skamensky/phone-kvm/hardware/phone-kvm.kicad_pcb

## KiCad design hardware/phone-kvm.kicad_pcb (2026-11-10)

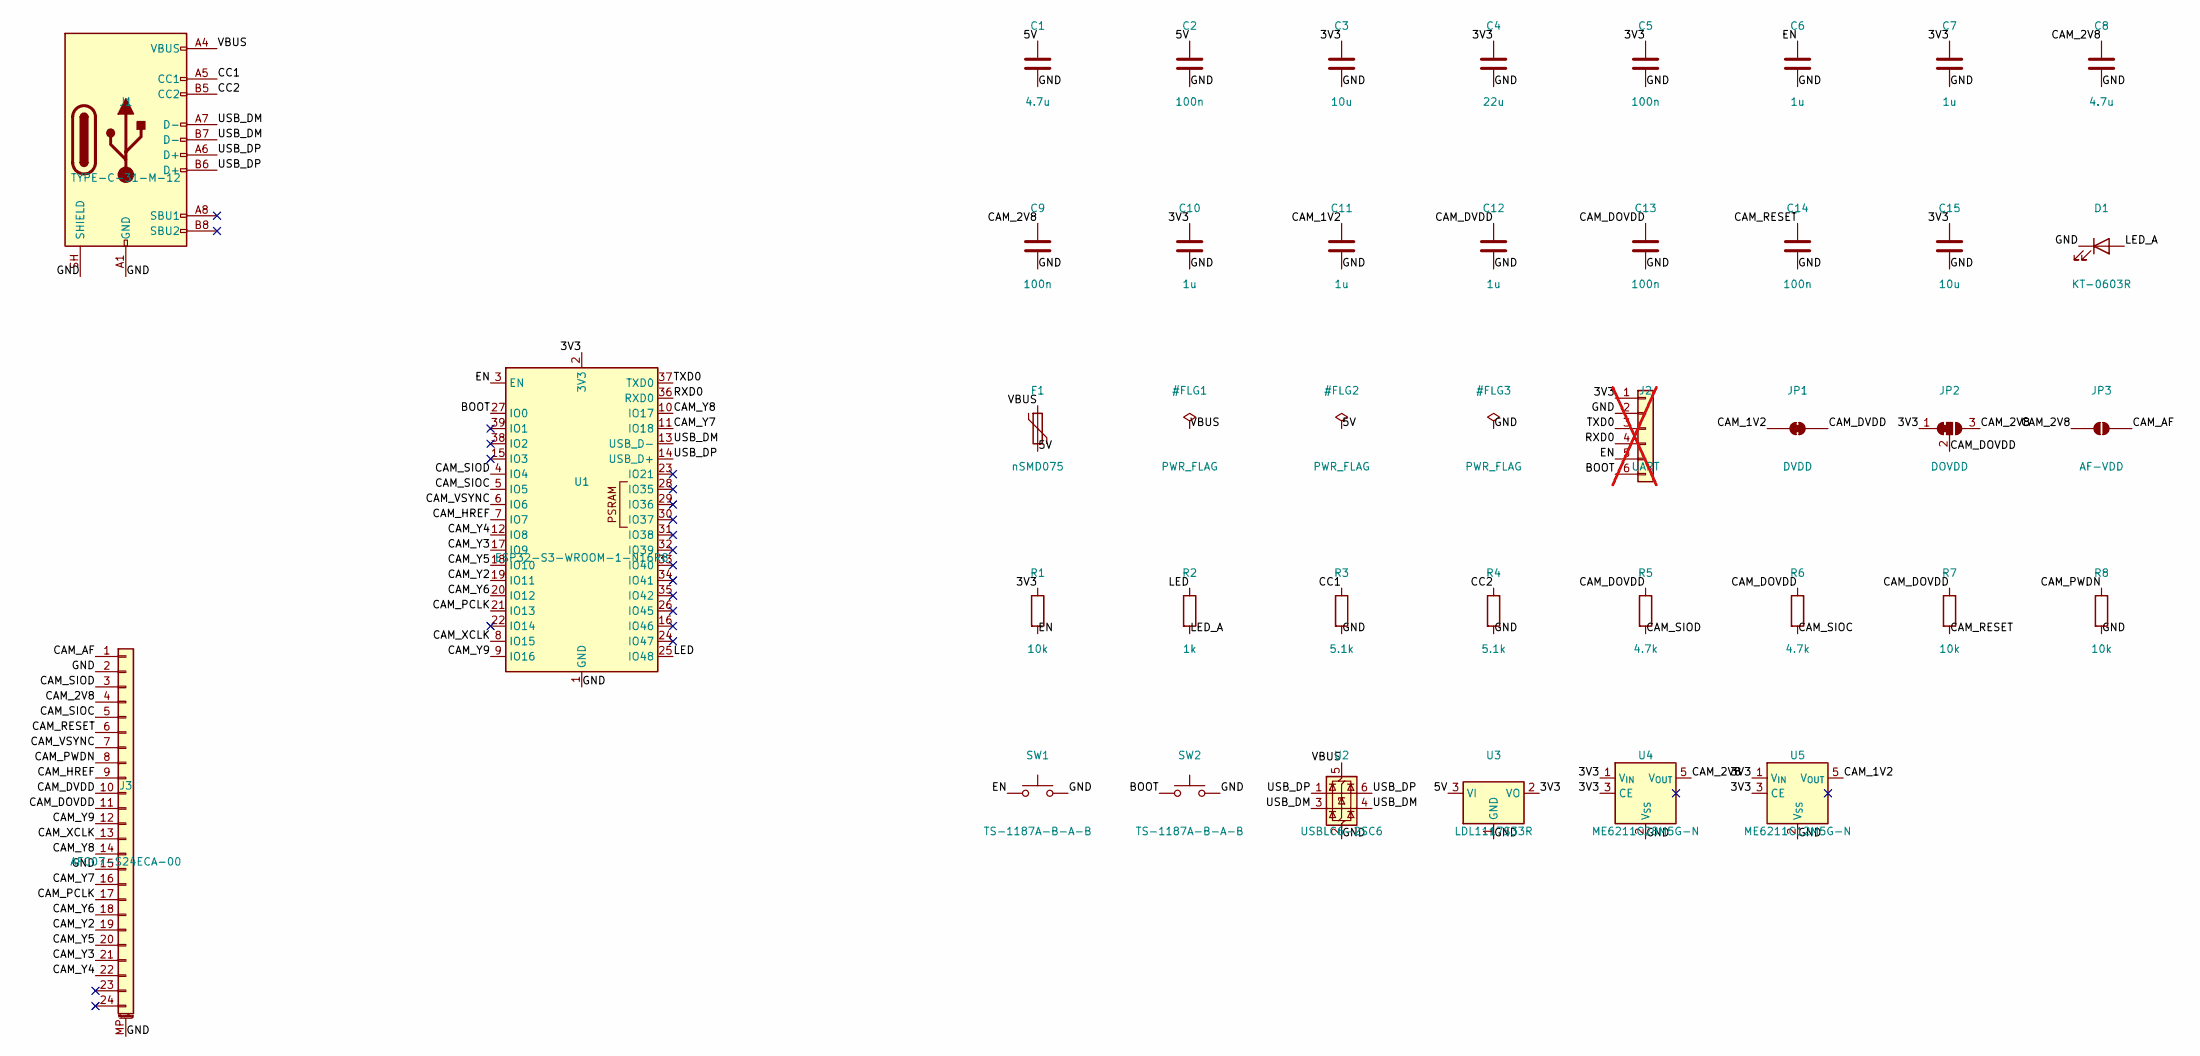
[picture p1: schematic phone-kvm.kicad_sch]

Parts:
C1, C8: 4.7u; C_0603_1608Metric; LCSC C19666
C2, C5, C9, C13, C14: 100n; C_0603_1608Metric; LCSC C14663
C3, C15: 10u; C_0603_1608Metric; LCSC C19702
C4: 22u; C_0805_2012Metric; LCSC C45783
C6, C7, C10, C11, C12: 1u; C_0603_1608Metric; LCSC C15849
D1: KT-0603R; LED_0603_1608Metric; LCSC C2286
F1: nSMD075; Fuse_1206_3216Metric; LCSC C70078
J1: TYPE-C-31-M-12; USB_C_Receptacle_HRO_TYPE-C-31-M-12; LCSC C165948
J2: UART; PinHeader_1x06_P2.54mm_Vertical; not fitted
J3: AFC07-S24ECA-00; Jushuo_AFC07-S24FCA-00_1x24-1MP_P0.50_Horizontal; LCSC C262643
JP1: DVDD; SolderJumper-2_P1.3mm_Bridged_RoundedPad1.0x1.5mm
JP2: DOVDD; SolderJumper-3_P1.3mm_Bridged12_RoundedPad1.0x1.5mm
JP3: AF-VDD; SolderJumper-2_P1.3mm_Open_RoundedPad1.0x1.5mm
R1, R7, R8: 10k; R_0603_1608Metric; LCSC C25804
R2: 1k; R_0603_1608Metric; LCSC C21190
R3, R4: 5.1k; R_0603_1608Metric; LCSC C23186
R5, R6: 4.7k; R_0603_1608Metric; LCSC C23162
SW1, SW2: TS-1187A-B-A-B; SW_Push_1P1T_XKB_TS-1187A; LCSC C318884
U1: ESP32-S3-WROOM-1-N16R8; ESP32-S3-WROOM-1; LCSC C2913202
U2: USBLC6-2SC6; SOT-23-6; LCSC C7519
U3: LDL1117S33R; SOT-223-3_TabPin2; LCSC C435835
U4: ME6211C28M5G-N; SOT-23-5; LCSC C53099
U5: ME6211C12M5G-N; SOT-23-5; LCSC C236672

Connections:
/3V3: C3.1, C4.1, C5.1, C7.1, C10.1, C15.1, J2.1, JP2.1 (A), R1.1, U1.2 (3V3), U3.2 (VO), U4.1 (V_{IN}), U4.3 (CE), U5.1 (V_{IN}), U5.3 (CE)
/5V: C1.1, C2.1, F1.2, U3.3 (VI)
/BOOT: J2.6, SW2.1, U1.27 (IO0)
/CAM_1V2: C11.1, JP1.1 (A), U5.5 (V_{OUT})
/CAM_2V8: C8.1, C9.1, J3.4, JP2.3 (B), JP3.1 (A), U4.5 (V_{OUT})
/CAM_AF: J3.1, JP3.2 (B)
/CAM_DOVDD: C13.1, J3.11, JP2.2 (C), R5.1, R6.1, R7.1
/CAM_DVDD: C12.1, J3.10, JP1.2 (B)
/CAM_HREF: J3.9, U1.7 (IO7)
/CAM_PCLK: J3.17, U1.21 (IO13)
/CAM_PWDN: J3.8, R8.1
/CAM_RESET: C14.1, J3.6, R7.2
/CAM_SIOC: J3.5, R6.2, U1.5 (IO5)
/CAM_SIOD: J3.3, R5.2, U1.4 (IO4)
/CAM_VSYNC: J3.7, U1.6 (IO6)
/CAM_XCLK: J3.13, U1.8 (IO15)
/CAM_Y2: J3.19, U1.19 (IO11)
/CAM_Y3: J3.21, U1.17 (IO9)
/CAM_Y4: J3.22, U1.12 (IO8)
/CAM_Y5: J3.20, U1.18 (IO10)
/CAM_Y6: J3.18, U1.20 (IO12)
/CAM_Y7: J3.16, U1.11 (IO18)
/CAM_Y8: J3.14, U1.10 (IO17)
/CAM_Y9: J3.12, U1.9 (IO16)
/CC1: J1.A5 (CC1), R3.1
/CC2: J1.B5 (CC2), R4.1
/EN: C6.1, J2.5, R1.2, SW1.1, U1.3 (EN)
/GND: C1.2, C2.2, C3.2, C4.2, C5.2, C6.2, C7.2, C8.2, C9.2, C10.2, C11.2, C12.2, C13.2, C14.2, C15.2, D1.1 (K), J1.A1 (GND), J1.A12 (GND), J1.B1 (GND), J1.B12 (GND), J1.SH (SHIELD), J2.2, J3.2, J3.15, J3.MP (MountPin), R3.2, R4.2, R8.2, SW1.2, SW2.2, U1.1 (GND), U1.40 (GND), U1.41 (GND), U2.2 (GND), U3.1 (GND), U4.2 (V_{SS}), U5.2 (V_{SS})
/LED: R2.1, U1.25 (IO48)
/LED_A: D1.2 (A), R2.2
/RXD0: J2.4, U1.36 (RXD0)
/TXD0: J2.3, U1.37 (TXD0)
/USB_DM: J1.A7 (D-), J1.B7 (D-), U1.13 (USB_D-), U2.3 (I/O2), U2.4 (I/O2)
/USB_DP: J1.A6 (D+), J1.B6 (D+), U1.14 (USB_D+), U2.1 (I/O1), U2.6 (I/O1)
/VBUS: F1.1, J1.A4 (VBUS), J1.A9 (VBUS), J1.B4 (VBUS), J1.B9 (VBUS), U2.5 (VBUS)

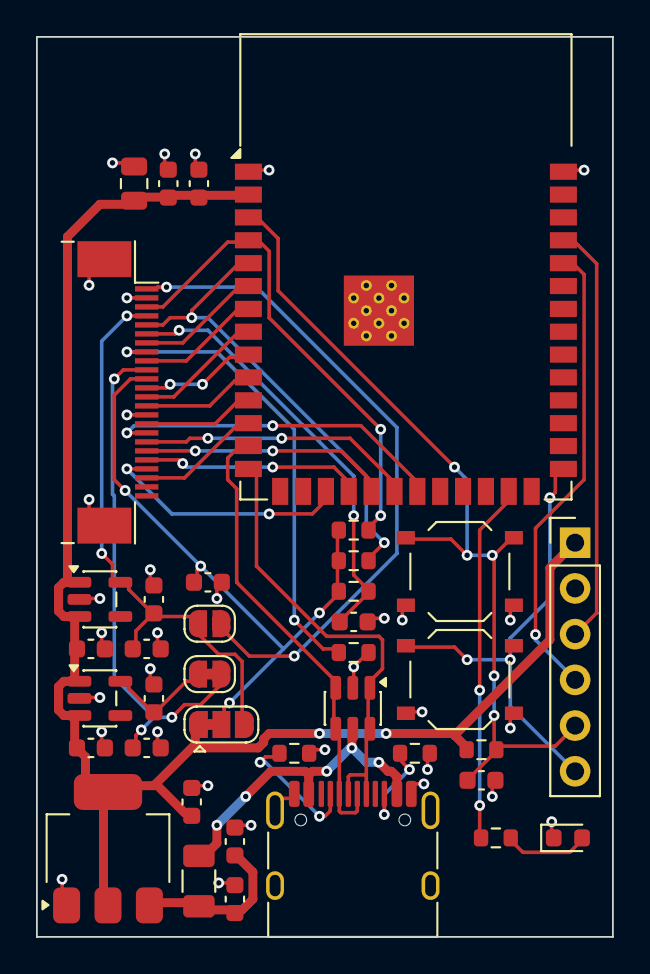
[picture p2: board phone-kvm.kicad_pcb from above]

Board: 2 copper layers, 32.0 x 50.0 mm, 38 parts (0 on the bottom side), 35 nets.
