skamensky/phone-kvm/tests/test_rig.py

"""The device against the virtual phone. Input goes in only through `phonectl` (USB HID) and
the screen comes out only through `phonectl screenshot`; adb is the oracle that says what
Android actually did. The device is the simulated board running the real firmware, and it sees
the phone through its camera. Needs `bin/rig up`; skipped otherwise.
"""
import io
import json
import os
import re
import shlex
import subprocess
import sys
import time
import xml.etree.ElementTree as ET

import pytest
from PIL import Image, ImageChops, ImageStat

from phone_kvm import hid  # noqa: E402

if "ANDROID_HOME" not in os.environ:
    pytest.skip("not in the project's Nix shell", allow_module_level=True)
from rig.__main__ import ADB, BUILD, CONFIG, ENV, PHONE, SERIAL, adb, status  # noqa: E402

if PHONE.exists() and PHONE.read_text() == "real":
    pytest.skip("the rig is up with a real phone; these tests check against the virtual one", allow_module_level=True)

if not status()["ready"]:
    pytest.skip("the rig is not up (bin/rig up)", allow_module_level=True)

DEVICE_ENV = {**os.environ, "PHONE_KVM_STATE": str(BUILD / "state")}


def phonectl(*args):
    done = subprocess.run([sys.executable, "-m", "phone_kvm.cli", *map(str, args)],
                          capture_output=True, text=True, env=DEVICE_ENV)
    result = json.loads(done.stdout)
    assert done.returncode == 0, result
    return result


def until(check, seconds=8):
    """Poll the oracle: the phone takes up to a second to show what it was told."""
    deadline = time.monotonic() + seconds
    while True:
        value = check()
        # An XML element without children is falsy, so compare with None and False explicitly.
        if (value is not None and value is not False) or time.monotonic() > deadline:
            return value if value is not False else None
        time.sleep(0.3)


def nodes():
    xml = adb("exec-out", "uiautomator", "dump", "/dev/tty", check=False).stdout
    xml = xml[:xml.rfind(">") + 1]
    return list(ET.fromstring(xml).iter("node")) if xml.startswith("<?xml") else []


def node(**attributes):
    return next((n for n in nodes() if all(n.get(k.rstrip("_").replace("_", "-")) == v for k, v in attributes.items())), None)


def bounds(n):
    return tuple(map(int, re.findall(r"\d+", n.get("bounds"))))


def centre(n, at=0.5):
    """A point in a node, in screenshot pixels (the unit phonectl takes)."""
    left, top, right, bottom = bounds(n)
    width, height = map(int, re.search(r"(\d+)x(\d+)", adb("shell", "wm", "size").stdout).groups())
    return (round((left + (right - left) * at) * SCREEN[0] / width), round((top + bottom) / 2 * SCREEN[1] / height))


def focus():
    return adb("shell", "dumpsys", "window").stdout.split("mCurrentFocus=")[1].split("\n")[0]


def events(action, seconds=1.5):
    """Raw kernel input events Android received while `action` ran."""
    listener = subprocess.Popen([ADB, "-s", SERIAL, "shell", "getevent", "-l"], stdout=subprocess.PIPE,
                                text=True, env=ENV)
    time.sleep(0.7)
    action()
    time.sleep(seconds)
    listener.terminate()
    return listener.communicate()[0]


@pytest.fixture(scope="module", autouse=True)
def awake():
    for secret in CREDENTIALS:   # a failed earlier run may have left the phone locked
        adb("shell", "locksettings", "clear", "--old", shlex.quote(secret), check=False)
    if "Awake" not in adb("shell", "dumpsys", "power").stdout:
        phonectl("key", "power")
    dismiss()
    phonectl("key", "home")
    # Just after boot the launcher is still starting.
    assert until(lambda: "NexusLauncherActivity" in focus() and node(text="Chrome") is not None, 90)
    global SCREEN
    phonectl("setup", "--device", CONFIG["device"], "--rotate", CONFIG["rotate"])
    # A camera finds the screen by its light: Settings is light to all four edges, the home
    # screen's wallpaper is not. Then the pointer on the home screen, which is still.
    phonectl("key", "meta+i")
    assert until(lambda: "com.android.settings" in focus())   # any of its pages is light
    time.sleep(2)
    phonectl("calibrate", "screen")
    phonectl("key", "home")
    assert until(lambda: "NexusLauncherActivity" in focus())
    time.sleep(1)
    result = phonectl("calibrate", "pointer")
    SCREEN = result["width"], result["height"]


@pytest.fixture(autouse=True)
def home():
    phonectl("key", "home")
    assert until(lambda: "NexusLauncherActivity" in focus() and node(text="Chrome") is not None)


PIN, PASSWORD, PATTERN = "271828", "Tr0ub4dor&3 {x}~", "14789"
CREDENTIALS = [PIN, PASSWORD, PATTERN]


def locked():
    return "isKeyguardShowing=true" in adb("shell", "dumpsys", "window").stdout


def dismiss():
    """Oracle-side cleanup: leave the phone awake and past a lock screen that has no credential."""
    def gone():
        adb("shell", "wm", "dismiss-keyguard")
        time.sleep(1)
        if locked():   # an entry screen left open after a refused credential: sleep and wake
            adb("shell", "input", "keyevent", "26")
            time.sleep(2)
            adb("shell", "input", "keyevent", "26")
            time.sleep(2)
        return not locked()
    assert until(gone, 15)


def wakefulness():
    return re.search(r"mWakefulness=(\w+)", adb("shell", "dumpsys", "power").stdout).group(1)


def lock_with(kind, secret):
    """Give the phone a screen lock (through adb: the oracle's side), then lock it with the
    power key and wake it to the lock screen, as its owner would find it."""
    assert "set to" in adb("shell", "locksettings", f"set-{kind}", shlex.quote(secret)).stdout
    phonectl("key", "power")
    assert until(lambda: wakefulness() != "Awake")
    time.sleep(1)
    phonectl("key", "power")
    assert until(lambda: wakefulness() == "Awake" and locked())
    time.sleep(1)
    x = SCREEN[0] // 2
    # Up to the entry screen, from above where an on-screen keyboard would be.
    phonectl("swipe", x, SCREEN[1] * 3 // 5, x, SCREEN[1] // 8, "--ms", 250)
    phonectl("screenshot", BUILD / "test-entry.png")   # as an agent would: look before typing


def settings():
    adb("shell", "am", "force-stop", "com.google.android.settings.intelligence")   # its search screen
    adb("shell", "am", "start", "-S", "-n", "com.android.settings/.Settings")
    assert until(lambda: node(text="Network & internet")) is not None


def test_android_enumerates_all_four_interfaces():
    dump = adb("shell", "dumpsys", "input").stdout
    devices = [block for block in dump.split("\n    ") if "vendor=0x1209, product=0x0001" in block]
    # Sources are listed in the lines that follow each identifier; search the whole dump section.
    section = dump[dump.index("Input Reader State"):]
    ours = re.findall(r"Device \d+: phone-kvm.*?(?=\n  Device \d+:|\Z)", section, re.S)
    assert len(ours) == 4, devices
    sources = " ".join(re.search(r"Sources: (.*)", block).group(1) for block in ours)
    for source in ("KEYBOARD", "TOUCHSCREEN", "MOUSE"):
        assert source in sources
    assert all("IsExternal: true" in block for block in ours)


def input_bits(descriptor):
    """Parse a HID report descriptor's short items; return the input report's length in bits."""
    bits = size = count = 0
    i = 0
    while i < len(descriptor):
        prefix = descriptor[i]
        length = (0, 1, 2, 4)[prefix & 3]
        value = int.from_bytes(descriptor[i + 1:i + 1 + length], "little")
        tag = prefix & 0xFC
        assert tag != 0x84, "report IDs would change every report's layout"
        if tag == 0x74:
            size = value
        elif tag == 0x94:
            count = value
        elif tag == 0x80:
            bits += size * count
        i += 1 + length
    assert i == len(descriptor), "descriptor ends inside an item"
    return bits


def test_the_firmware_describes_the_reports_the_host_sends():
    """The report descriptors Android read from the board, against the host's report lengths."""
    dump = adb("shell", "su 0 sh -c 'for d in /sys/bus/hid/devices/*:1209:0001.*; do "
               "od -An -v -tx1 $d/report_descriptor | tr -d \" \\n\"; echo; done'").stdout.split()
    assert sorted(input_bits(bytes.fromhex(line)) for line in dump) == sorted(
        length * 8 for _, length in hid.INTERFACES.values())


def display():
    """What the phone's panel shows, from the emulator itself (the oracle)."""
    folder = BUILD / "run" / "oracle"
    folder.mkdir(exist_ok=True)
    for old in folder.glob("*.png"):
        old.unlink()
    adb("emu", "screenrecord", "screenshot", str(folder))
    return Image.open(next(folder.glob("*.png"))).convert("RGB")


def test_screenshot_shows_what_the_phone_displays():
    path = BUILD / "test-screenshot.png"
    shot = phonectl("screenshot", path)
    seen = Image.open(path).convert("RGB")
    assert seen.size == (shot["width"], shot["height"]) == SCREEN
    truth = display()
    assert abs(seen.width / seen.height - truth.width / truth.height) < 0.01
    difference = ImageStat.Stat(ImageChops.difference(seen, truth.resize(seen.size))).mean
    assert max(difference) < 6, difference


def test_lock_screen_entry_is_visible():
    """Android blanks secure windows on its video output; a camera sees the panel itself."""
    try:
        lock_with("pin", PIN)
        assert until(lambda: node(resource_id="com.android.systemui:id/pinEntry")) is not None
        path = BUILD / "test-lock.png"
        phonectl("screenshot", path)
        seen = Image.open(path).convert("L")
        difference = ImageStat.Stat(ImageChops.difference(seen, display().convert("L").resize(seen.size))).mean
        assert seen.getextrema()[1] > 150 and difference[0] < 6, difference
        phonectl("type", PIN)
        phonectl("key", "enter")
        assert until(lambda: not locked())
    finally:
        adb("shell", "locksettings", "clear", "--old", PIN, check=False)


def cursor(path):
    """Where the cursor's tip is in a screenshot, by comparing with one where it is elsewhere."""
    change = ImageChops.difference(Image.open(path), Image.open(BUILD / "test-cursor-away.png")).convert("L")
    # Between the status bar, whose clock changes, and the other cursor at the bottom.
    top = SCREEN[1] // 12
    left, upper = change.crop((0, top, SCREEN[0], SCREEN[1] * 3 // 4)).point(lambda v: 255 if v > 48 else 0).getbbox()[:2]
    return left, upper + top


def test_screenshot_says_where_the_cursor_is_and_never_predates_an_input():
    path, slack = BUILD / "test-cursor.png", max(4, SCREEN[0] // 100)
    phonectl("mouse", "to", SCREEN[0] // 2, SCREEN[1] * 7 // 8)
    phonectl("screenshot", BUILD / "test-cursor-away.png")
    # Empty wallpaper: icons and the date at the top react to hovering.
    for at in [(0.3, 0.45), (0.7, 0.3), (0.85, 0.4)]:
        target = [round(SCREEN[0] * at[0]), round(SCREEN[1] * at[1])]
        phonectl("mouse", "to", *target)
        shot = phonectl("screenshot", path)
        # The cursor moves more than a screenshot pixel per count, so it lands within one.
        assert all(abs(shot["pointer"][i] - target[i]) <= 1 for i in (0, 1)) and shot["settled"], (shot, target)
        seen = cursor(path)
        assert abs(seen[0] - target[0]) <= slack and abs(seen[1] - target[1]) <= slack, (seen, target)
    # A relative move is tracked too, and a screenshot taken at once, with no settling, already
    # shows it: it waits out the measured delay between an input and the image.
    phonectl("mouse", "move", -60, 40)
    shot = phonectl("screenshot", path, "--settle-ms", 0)
    assert shot["ms_since_input"] >= phonectl("status")["calibration"]["latency_ms"]
    seen = cursor(path)
    assert shot["pointer"][0] < target[0] and shot["pointer"][1] > target[1]
    assert abs(seen[0] - shot["pointer"][0]) <= slack and abs(seen[1] - shot["pointer"][1]) <= slack, (seen, shot)


def test_tap_focuses_a_field_and_typing_enters_every_character():
    settings()
    phonectl("tap", *centre(node(text="Search Settings")))
    assert until(lambda: node(class_="android.widget.EditText", focused="true")) is not None
    text = "Hello, World 123 " + "".join(chr(c) for c in range(33, 127))
    phonectl("type", text)
    assert until(lambda: node(class_="android.widget.EditText", text=text)) is not None, \
        node(class_="android.widget.EditText", focused="true").get("text")
    phonectl("key", "ctrl+a", "backspace")
    assert until(lambda: node(class_="android.widget.EditText", focused="true").get("text") != text)


def test_back_home_and_recents_keys():
    settings()
    phonectl("key", "recents")
    assert until(lambda: "NexusLauncherActivity" in focus())   # the app switcher is the launcher's
    phonectl("key", "back")
    assert until(lambda: "com.android.settings" in focus())
    phonectl("key", "home")
    assert until(lambda: "NexusLauncherActivity" in focus())


def test_volume_media_and_system_keys_arrive_as_the_right_keys():
    expected = {"volume-up": "KEY_VOLUMEUP", "volume-down": "KEY_VOLUMEDOWN", "mute": "KEY_MUTE",
                "play-pause": "KEY_PLAYPAUSE", "next-track": "KEY_NEXTSONG",
                "previous-track": "KEY_PREVIOUSSONG", "search": "KEY_SEARCH", "menu": "KEY_MENU"}
    log = events(lambda: phonectl("key", *expected))
    assert re.findall(r"EV_KEY\s+(\w+)\s+DOWN", log) == list(expected.values())


def test_power_key_sleeps_and_wakes():
    phonectl("key", "power")
    assert until(lambda: wakefulness() != "Awake")
    phonectl("key", "power")
    assert until(lambda: wakefulness() == "Awake")
    dismiss()


def test_unlock_with_a_pin():
    try:
        lock_with("pin", PIN)
        phonectl("type", PIN)
        phonectl("key", "enter")
        assert until(lambda: not locked())
    finally:
        adb("shell", "locksettings", "clear", "--old", PIN, check=False)


def test_unlock_with_a_password():
    try:
        lock_with("password", PASSWORD)
        phonectl("type", PASSWORD)
        phonectl("key", "enter")
        assert until(lambda: not locked())
    finally:
        adb("shell", "locksettings", "clear", "--old", shlex.quote(PASSWORD), check=False)


def test_unlock_with_a_pattern():
    try:
        lock_with("pattern", PATTERN)
        grid = until(lambda: node(resource_id="com.android.systemui:id/lockPatternView"))
        assert grid is not None
        left, top, right, bottom = bounds(grid)
        width, height = map(int, re.search(r"(\d+)x(\d+)", adb("shell", "wm", "size").stdout).groups())
        points = []
        for dot in map(int, PATTERN):   # dots are numbered 1-9, left to right, top to bottom
            column, row = (dot - 1) % 3, (dot - 1) // 3
            points += [round((left + (right - left) * (2 * column + 1) / 6) * SCREEN[0] / width),
                       round((top + (bottom - top) * (2 * row + 1) / 6) * SCREEN[1] / height)]
        phonectl("swipe", *points, "--ms", 900, "--hold-ms", 150)
        assert until(lambda: not locked())
    finally:
        adb("shell", "locksettings", "clear", "--old", PATTERN, check=False)


def test_long_press_opens_the_launcher_menu():
    phonectl("tap", SCREEN[0] // 2, SCREEN[1] // 2, "--hold-ms", 900)
    assert until(lambda: node(text="Wallpaper & style")) is not None
    phonectl("key", "back")


def test_swipe_scrolls():
    settings()
    before = bounds(node(text="Network & internet"))
    x = SCREEN[0] // 2
    phonectl("swipe", x, SCREEN[1] * 3 // 4, x, SCREEN[1] // 2, "--hold-ms", 200)

    def scrolled():
        after = node(text="Network & internet")
        return after is None or bounds(after)[1] < before[1] - 200
    assert until(scrolled)


def test_pinch_is_two_fingers():
    x, y = SCREEN[0] // 2, SCREEN[1] // 3
    log = events(lambda: phonectl("pinch", x, y, "--start", 80, "--end", 300))
    slots = set(re.findall(r"ABS_MT_SLOT\s+(\w+)", log))
    assert {"00000001"} <= slots, log[-2000:]
    assert log.count("ABS_MT_TRACKING_ID") >= 4   # two fingers down, two up


def test_mouse_points_clicks_and_scrolls():
    settings()
    phonectl("mouse", "scroll", 6)
    assert until(lambda: node(text="Network & internet") is None or bounds(node(text="Network & internet"))[1] < 300)
    phonectl("mouse", "scroll", -12)
    target = until(lambda: node(text="Network & internet"))
    assert target is not None
    phonectl("mouse", "to", *centre(target))
    phonectl("mouse", "click")
    assert until(lambda: node(text="Internet") is not None and node(text="Hotspot & tethering") is not None)
