skamensky/phone-kvm/(commit log)

2026-11-09 An agent can use an Android phone through USB HID and HDMI: device software, virtual rig with the Android emulator, and tests
2026-11-10 A camera pointed at the phone is a second view, with a virtual camera in the rig; calibration ties the image to the pointer and to time; a study of how much camera resolution reading a screen takes
2026-11-10 The device is an ESP32-S3 board: firmware with USB HID, camera and a TCP service, a simulated board in QEMU it runs on, and phonectl driving it over the network
    The Linux gadget, HDMI view and v4l2loopback are gone. The rig boots the real firmware in
    Espressif's QEMU with a DWC2 USB device controller and a camera added, plugs it into the
    Android emulator over USB/IP, and all 21 tests pass through it. Mouse moves are single
    16-bit reports after a pause, which Android scales by a constant.
2026-11-10 The board has a KiCad design generated from one circuit description and checked against the firmware's pins; recents opens the app switcher on Android 15+, pointer calibration ignores focus rings and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
    [phone-kvm.kicad_pcb, phone-kvm.kicad_sch]
2026-11-10 The rig can drive a real phone: rig up --phone real gives it the simulated board's HID interfaces over adb (uhid), with a webcam as the board's camera
2026-11-10 The live camera view can show a phone lying sideways upright: rig.view --rotate
2026-11-10 mouse to corrects itself by camera: it finds the cursor by moving it aside and moves it by what is missing
